LtTadokoro/handheld_thermal_imager/docs/images/6.jpg

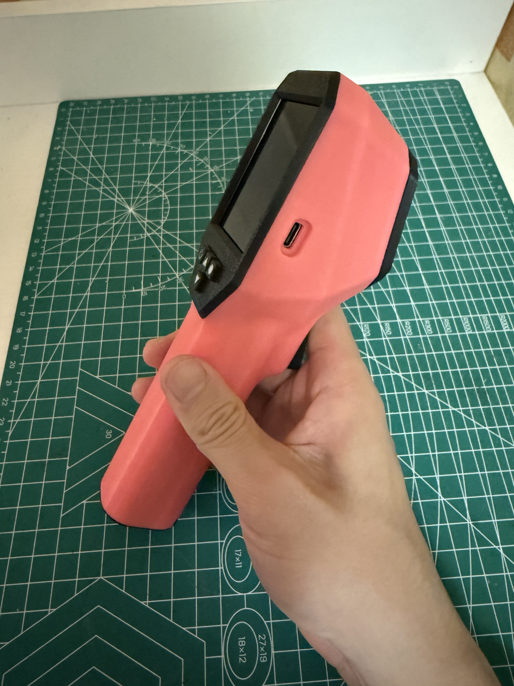
docs/images/6.jpg
