LtTadokoro/handheld_thermal_imager/docs/images/7.jpg

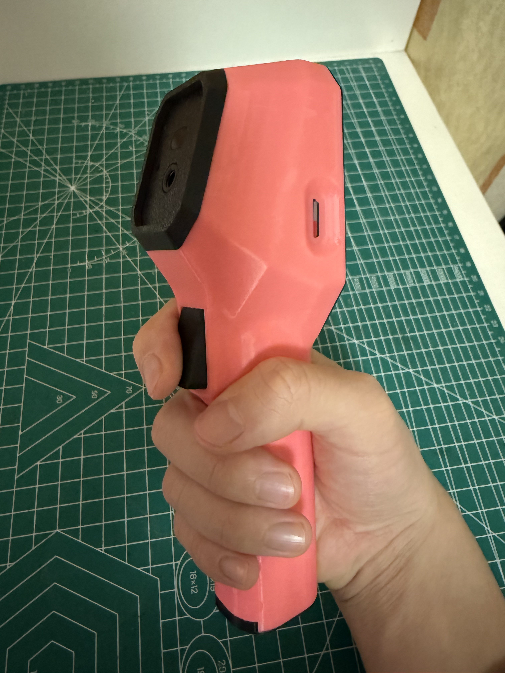
docs/images/7.jpg
