LtTadokoro/handheld_thermal_imager/docs/images/8.jpg

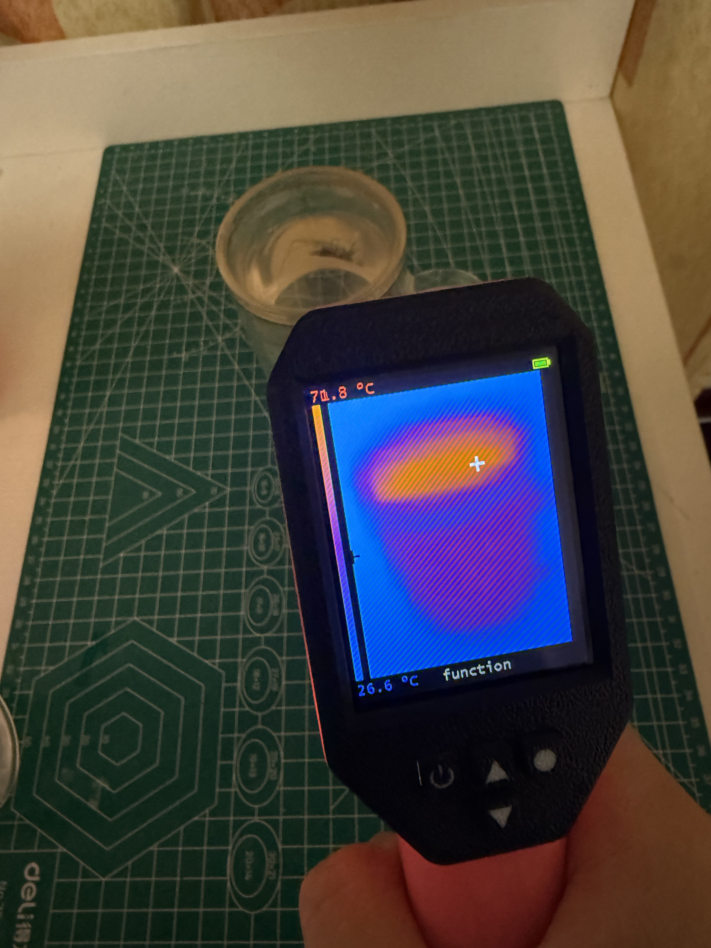
docs/images/8.jpg
