LtTadokoro/handheld_thermal_imager/docs/images/9.jpg

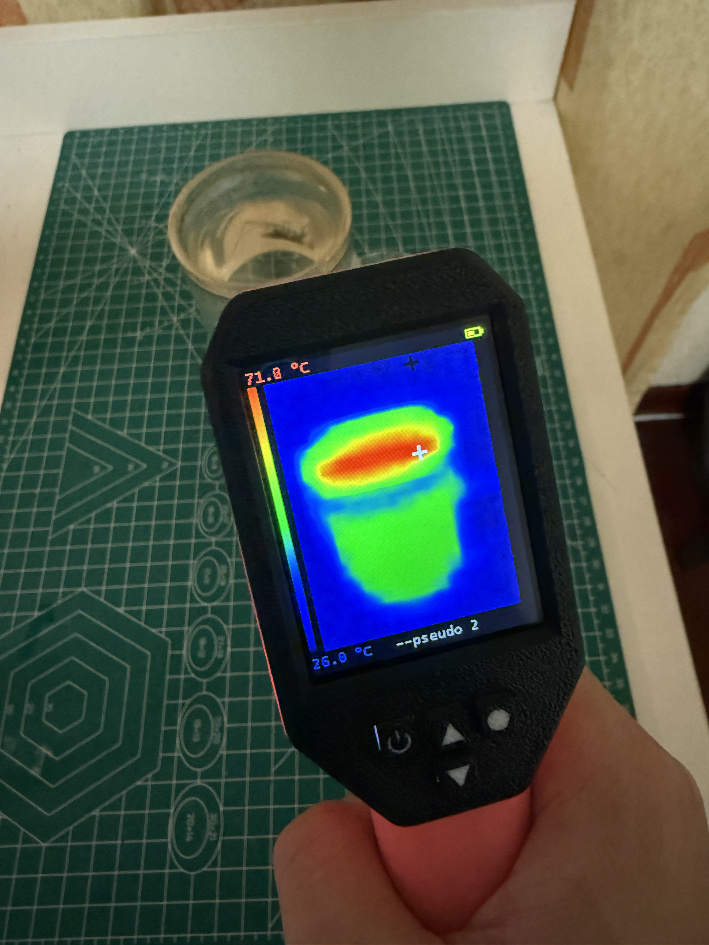
docs/images/9.jpg
