LtTadokoro/handheld_thermal_imager/docs/images/10.jpg

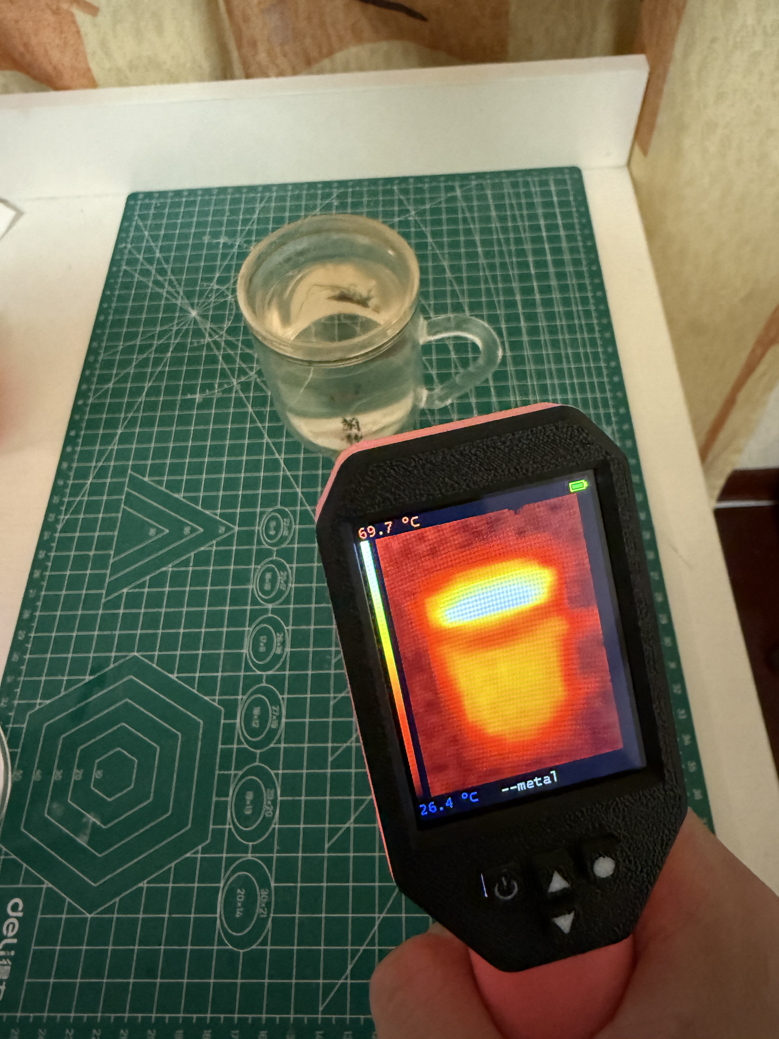
docs/images/10.jpg
