LtTadokoro/handheld_thermal_imager/docs/images/11.png

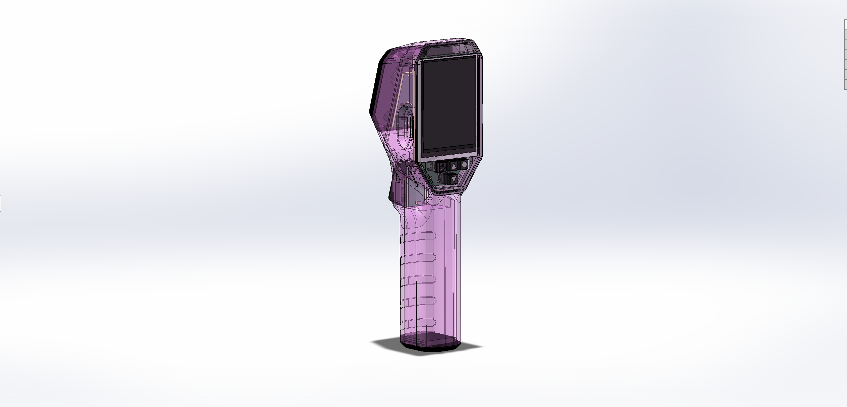
docs/images/11.png
