LtTadokoro/handheld_thermal_imager/docs/images/13.png

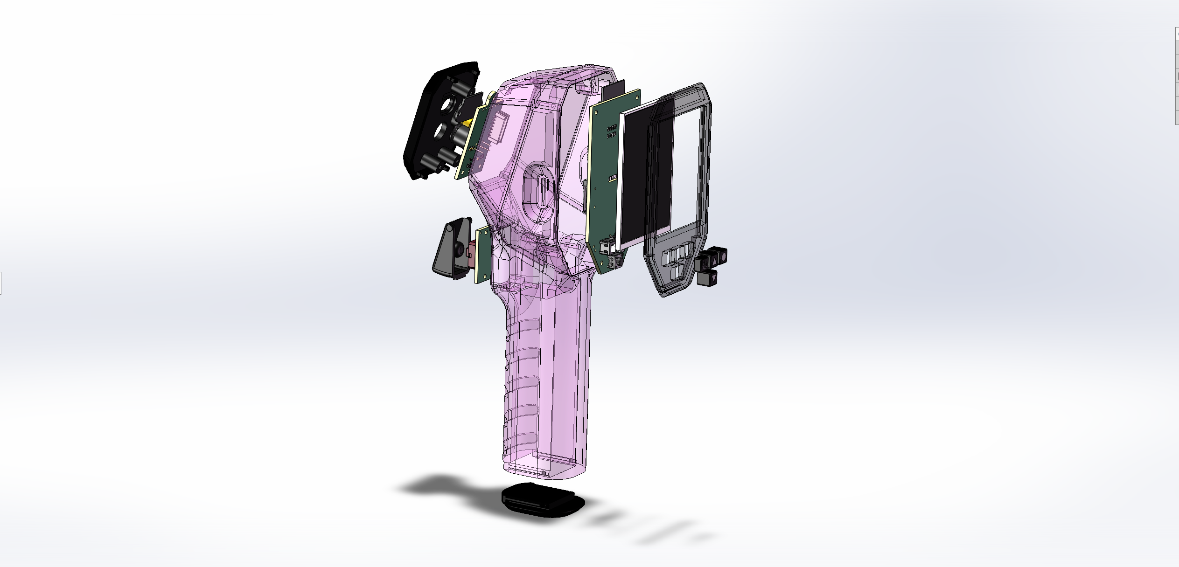
docs/images/13.png
