LtTadokoro/handheld_thermal_imager/docs/images/firmware_tools.png

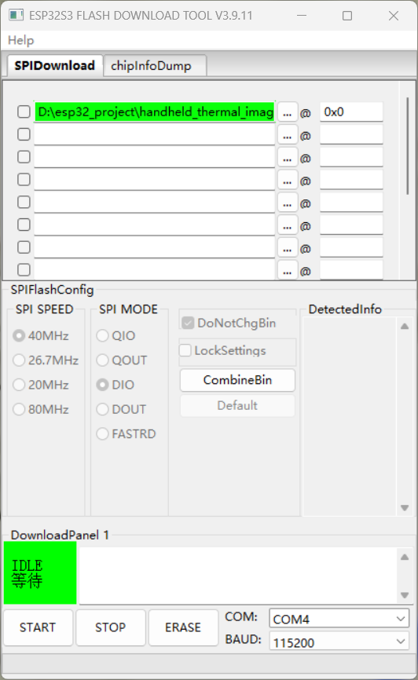
docs/images/firmware_tools.png
