LtTadokoro/handheld_thermal_imager/docs/images/IMAGE030.BMP

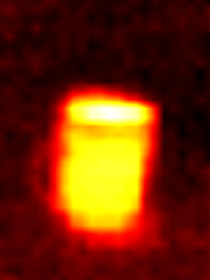
docs/images/IMAGE030.BMP
