LtTadokoro/handheld_thermal_imager/docs/images/IMAGE031.BMP

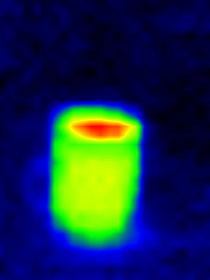
docs/images/IMAGE031.BMP
