LtTadokoro/handheld_thermal_imager/docs/images/IMAGE033.BMP

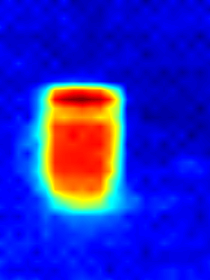
docs/images/IMAGE033.BMP
