LtTadokoro/handheld_thermal_imager/enclosure/stl/main_body.STL

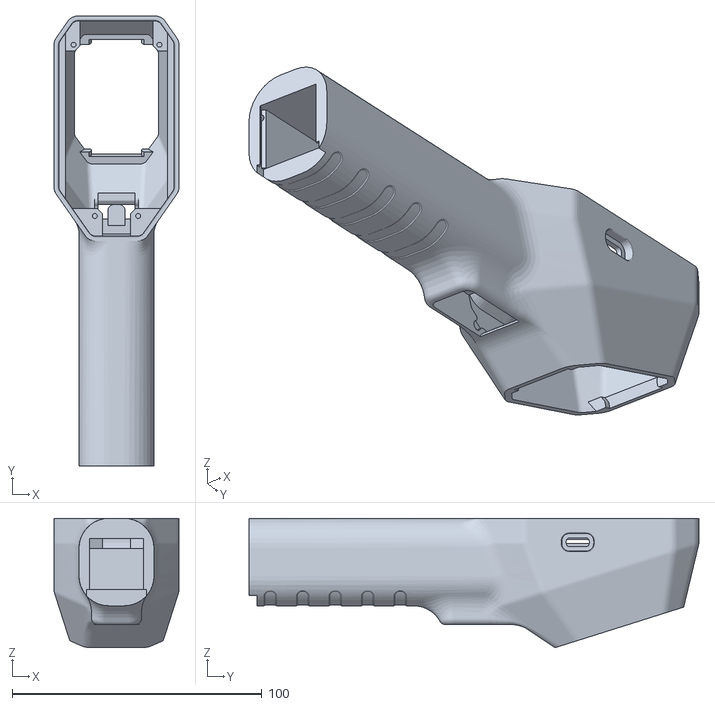
[picture p17: CAD file, 2026-10-19]
enclosure/stl/main_body.STL
50.0 x 180.0 x 51.8
