LtTadokoro/handheld_thermal_imager/enclosure/stl/front.STL

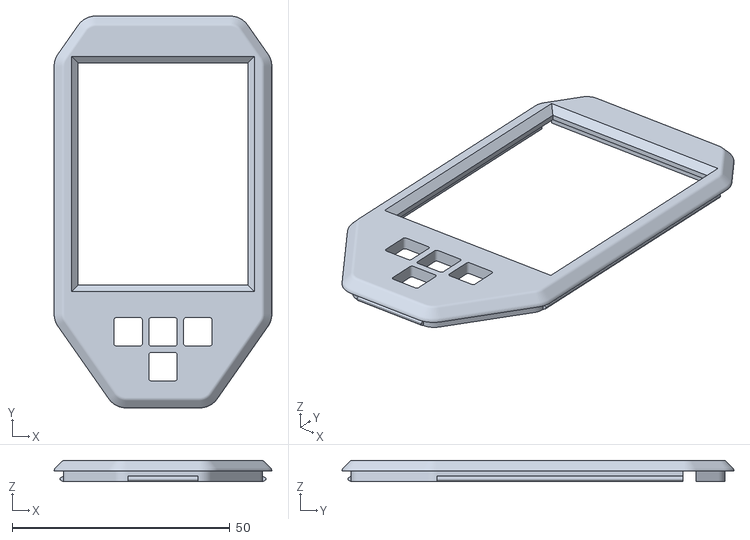
[picture p18: CAD file, 2026-10-19]
enclosure/stl/front.STL
50.0 x 90.0 x 4.90
