LtTadokoro/handheld_thermal_imager/enclosure/stl/up_down_key.STL

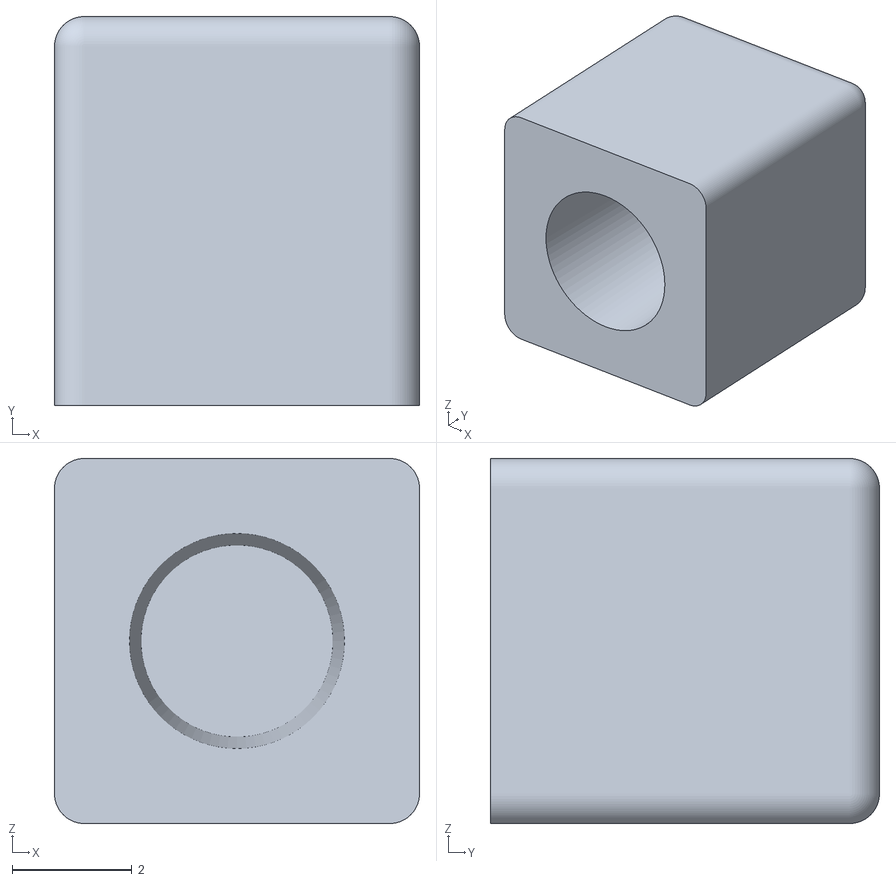
[picture p19: CAD file, 2026-10-19]
enclosure/stl/up_down_key.STL
6.10 x 6.50 x 6.10
