LtTadokoro/handheld_thermal_imager/enclosure/stl/trigger.STL

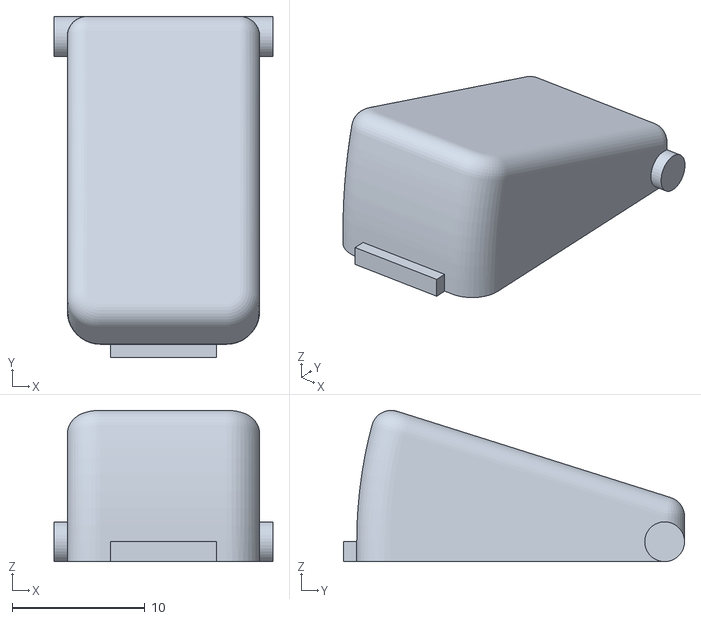
[picture p20: CAD file, 2026-10-19]
enclosure/stl/trigger.STL
16.5 x 25.7 x 11.4
