LtTadokoro/handheld_thermal_imager/enclosure/stl/top_2_no_tof.STL

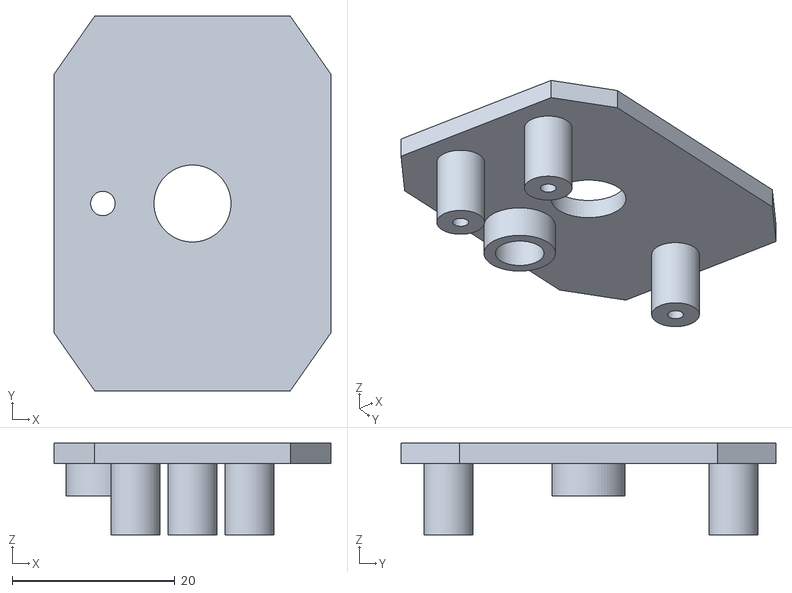
[picture p21: CAD file, 2026-10-19]
enclosure/stl/top_2_no_tof.STL
34.0 x 46.0 x 11.2
