LtTadokoro/handheld_thermal_imager/enclosure/stl/bottom.STL

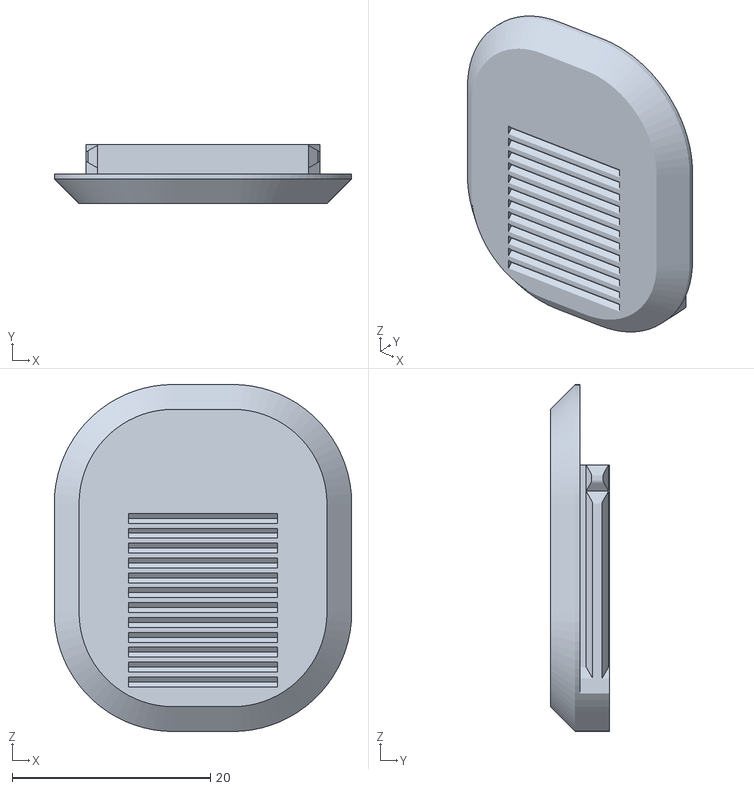
[picture p22: CAD file, 2026-10-19]
enclosure/stl/bottom.STL
30.0 x 6.00 x 35.0
