LtTadokoro/handheld_thermal_imager/enclosure/stl/power_key.STL

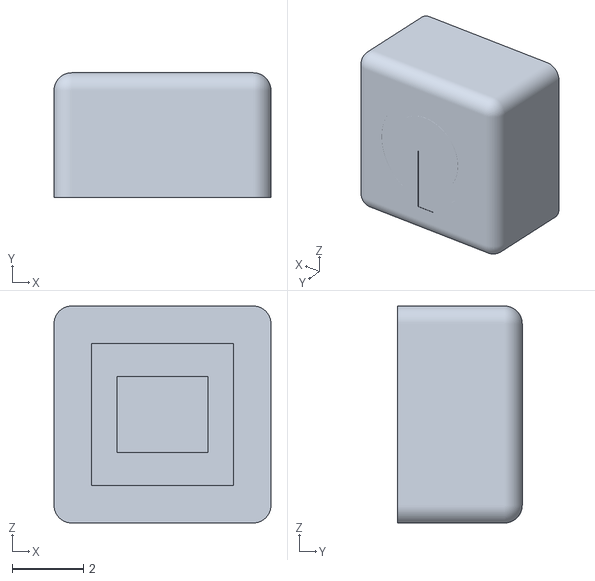
[picture p23: CAD file, 2026-10-19]
enclosure/stl/power_key.STL
6.10 x 3.50 x 6.10
