LtTadokoro/handheld_thermal_imager/enclosure/stl/top_1.STL

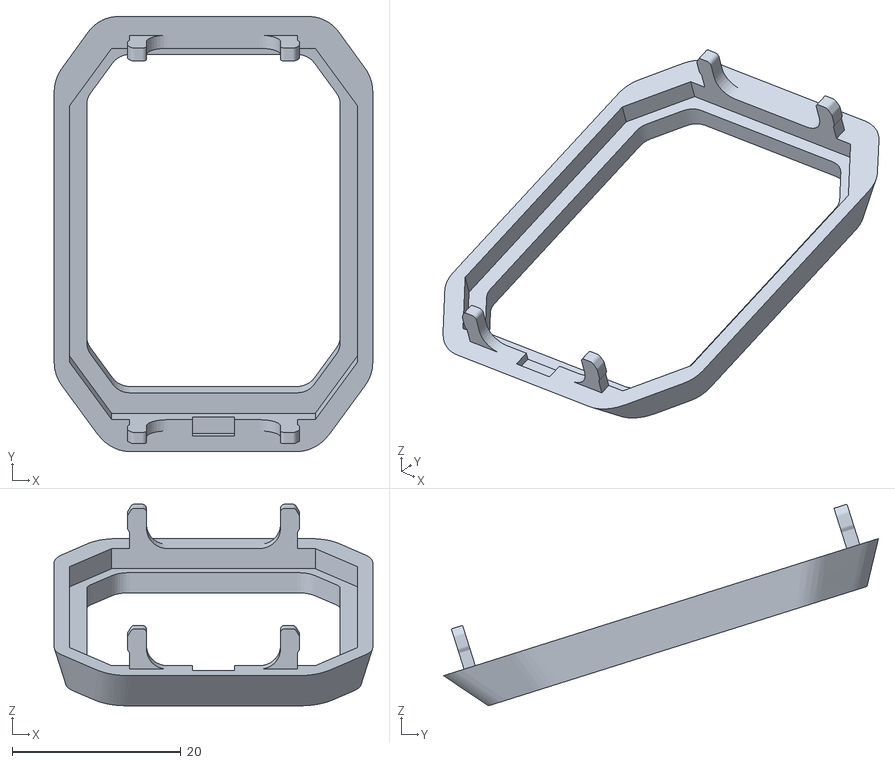
[picture p24: CAD file, 2026-10-19]
enclosure/stl/top_1.STL
37.7 x 51.5 x 23.9
