LtTadokoro/handheld_thermal_imager/(list of files, cad)

Other CAD files:
enclosure/step/project.STEP
enclosure/stl/enter_key.STL
enclosure/stl/top_2.STL
enclosure/3mf/project.3mf
