LtTadokoro/handheld_thermal_imager/hardware/schematic/SCH_Schematic.pdf

1

2

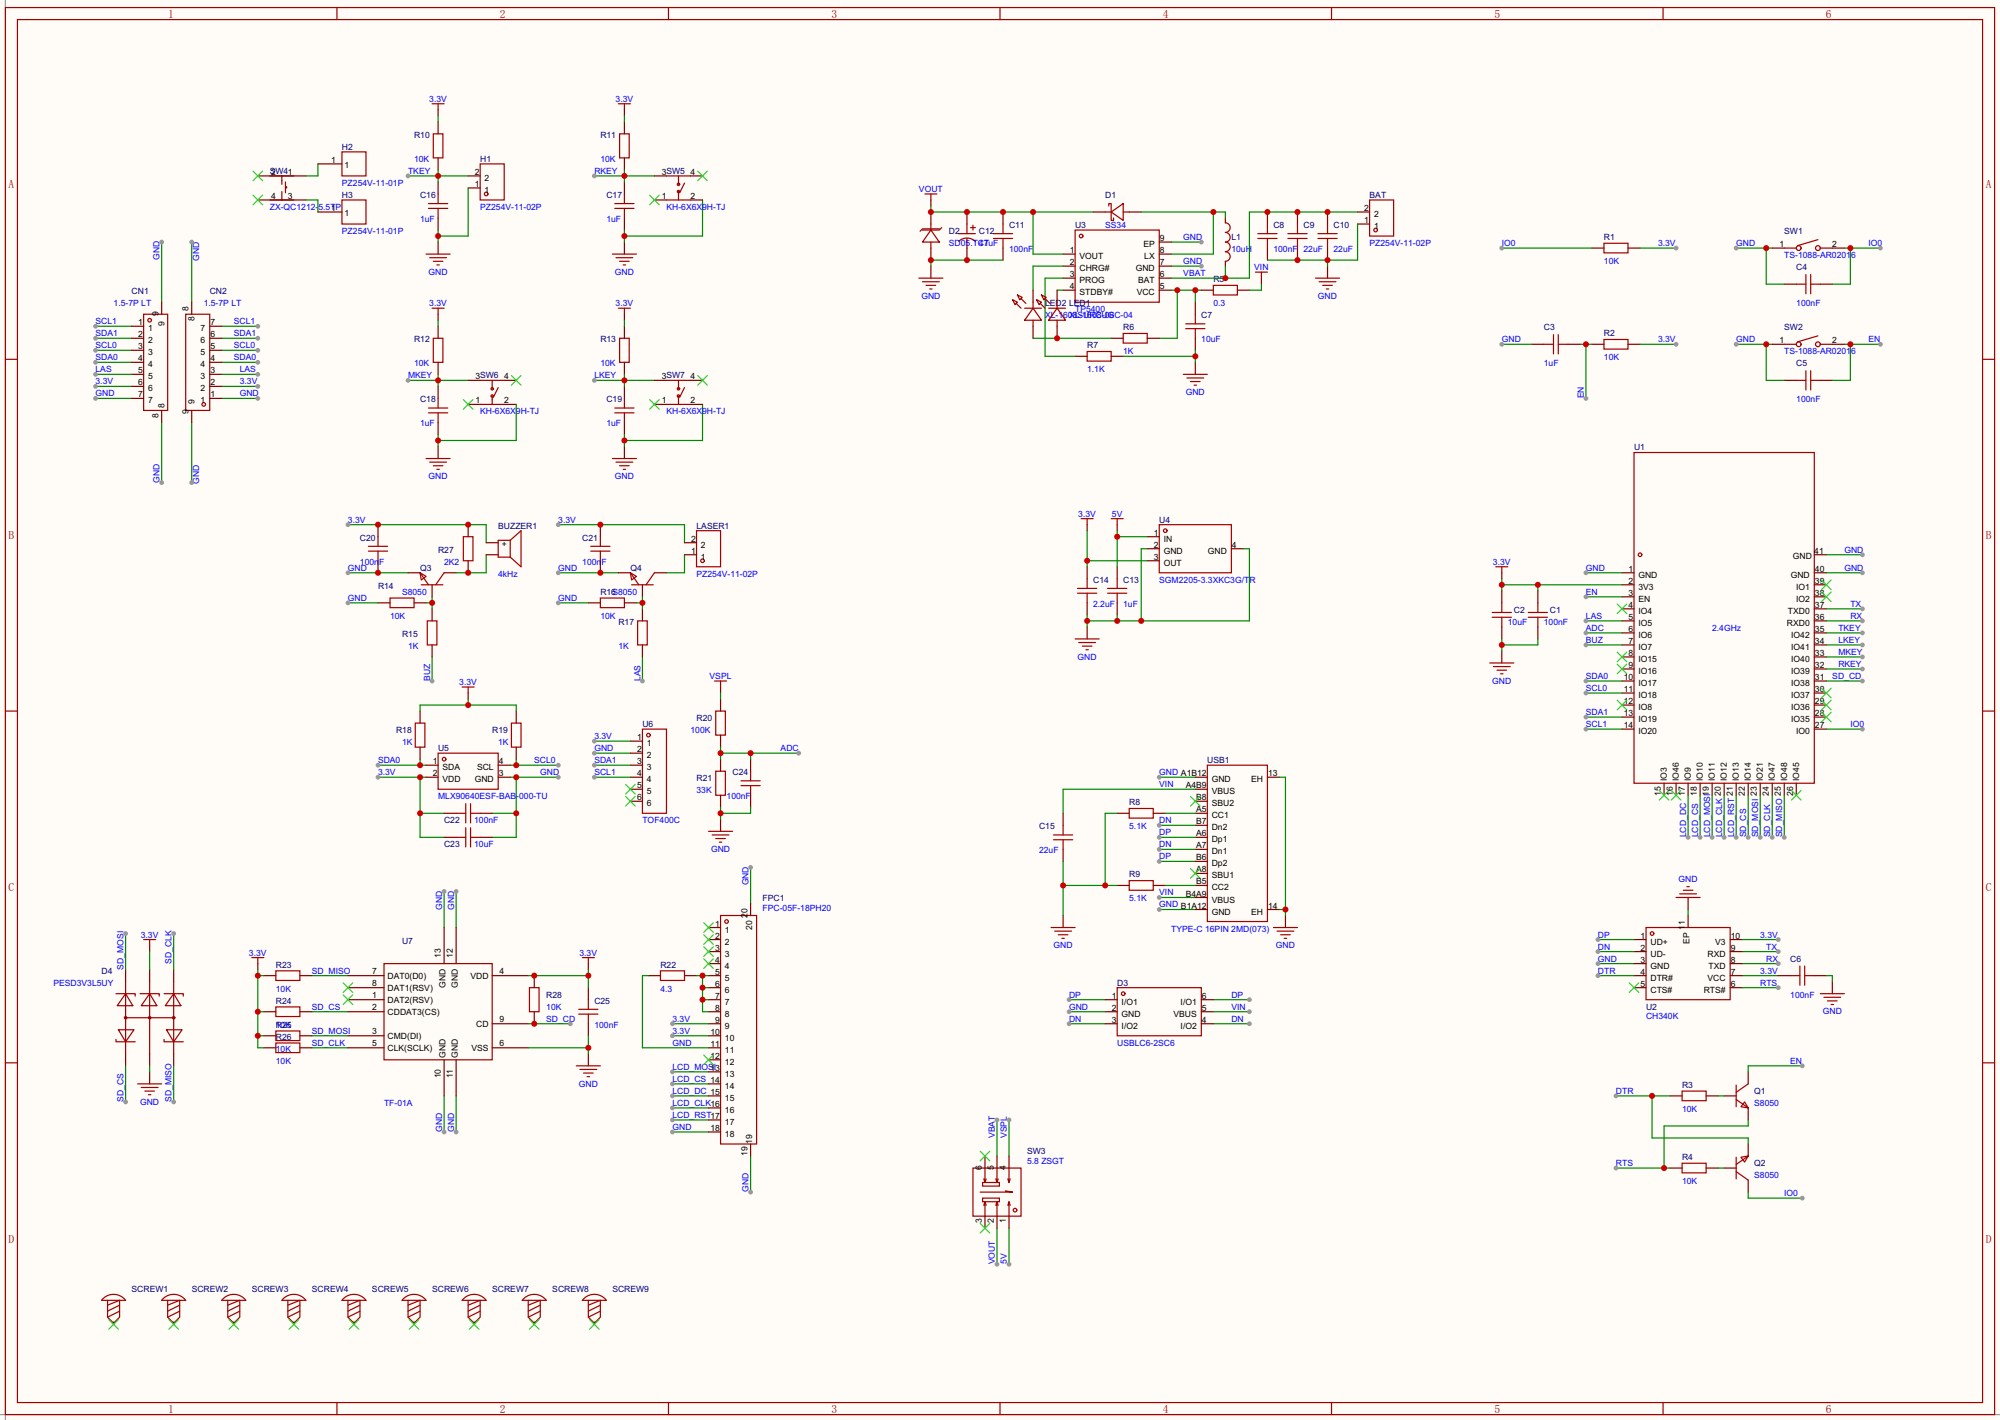
[picture p25: page 1]
